jonbob0687/DEV1028/pcb/revBnotes.txt

1. mosfet - resistor to shunt charge on gate
2. pullup or pulldown resistors to keep bus translator at known levels
