jonbob0687/DEV1028/pcb/export/BillOfMaterialsrB.xlsx

Reference | Value | Footprint | Qty | DNP | MPN
C1,C2 | 100nF | Capacitor_SMD:C_0603_1608Metric | 2 |  | STASH
C3 | 1uF | Capacitor_SMD:C_0603_1608Metric | 1 |  | CC0603KRX7R9BB105
C4 | 1uF | Capacitor_SMD:C_1206_3216Metric_Pad1.33x1.80mm_HandSolder | 1 |  | HMK316B7105KL-T
D1 | 5.1V | Diode_SMD:D_SOD-323_HandSoldering | 1 |  | DNP
J1 | ScrewTerms | GM_Connector_PhoenixContact:phoenix_contact_1984691 | 1 |  | 1984691
Q1,Q2 | MMBT3904 | Package_TO_SOT_SMD:SOT-23-3 | 2 |  | WORK
Q3,Q4 | SI2304BDS-T1-GE3 | Package_TO_SOT_SMD:SOT-23 | 2 |  | SI2304BDS-T1-GE3
R1 | 10K | Resistor_SMD:R_0603_1608Metric | 1 |  | RC0603FR-0710KL
R2 | 4K7 | Resistor_SMD:R_0603_1608Metric | 1 |  | y
R3 | 2K | Resistor_SMD:R_0603_1608Metric | 1 |  | y
R4 | 20K | Resistor_SMD:R_0603_1608Metric | 1 |  | y
R5 | 100K | Resistor_SMD:R_0603_1608Metric | 1 |  | y
R6 | 680R | Resistor_SMD:R_0603_1608Metric | 1 |  | y
R7,R9 | 1K | Resistor_SMD:R_0603_1608Metric | 2 |  | y
R8,R10 | 120R | Resistor_SMD:R_0603_1608Metric | 2 |  | y
U1 | OKI-78SR-5/1.5-W36-C | Package_TO_SOT_THT:TO-220-3_Vertical | 1 |  | old
U2 | SN74AVC8T245PW | Package_SO:TSSOP-24_4.4x7.8mm_P0.65mm | 1 |  | y
U3 | XIAO-ESP32-S3-SMD | Seeed Studio XIAO Series Library:XIAO-ESP32S3-SMD | 1
