jonbob0687/DEV1028/pcb/200280rB.kicad_pcb

## KiCad design pcb/200280rB.kicad_pcb (2025-03-09)

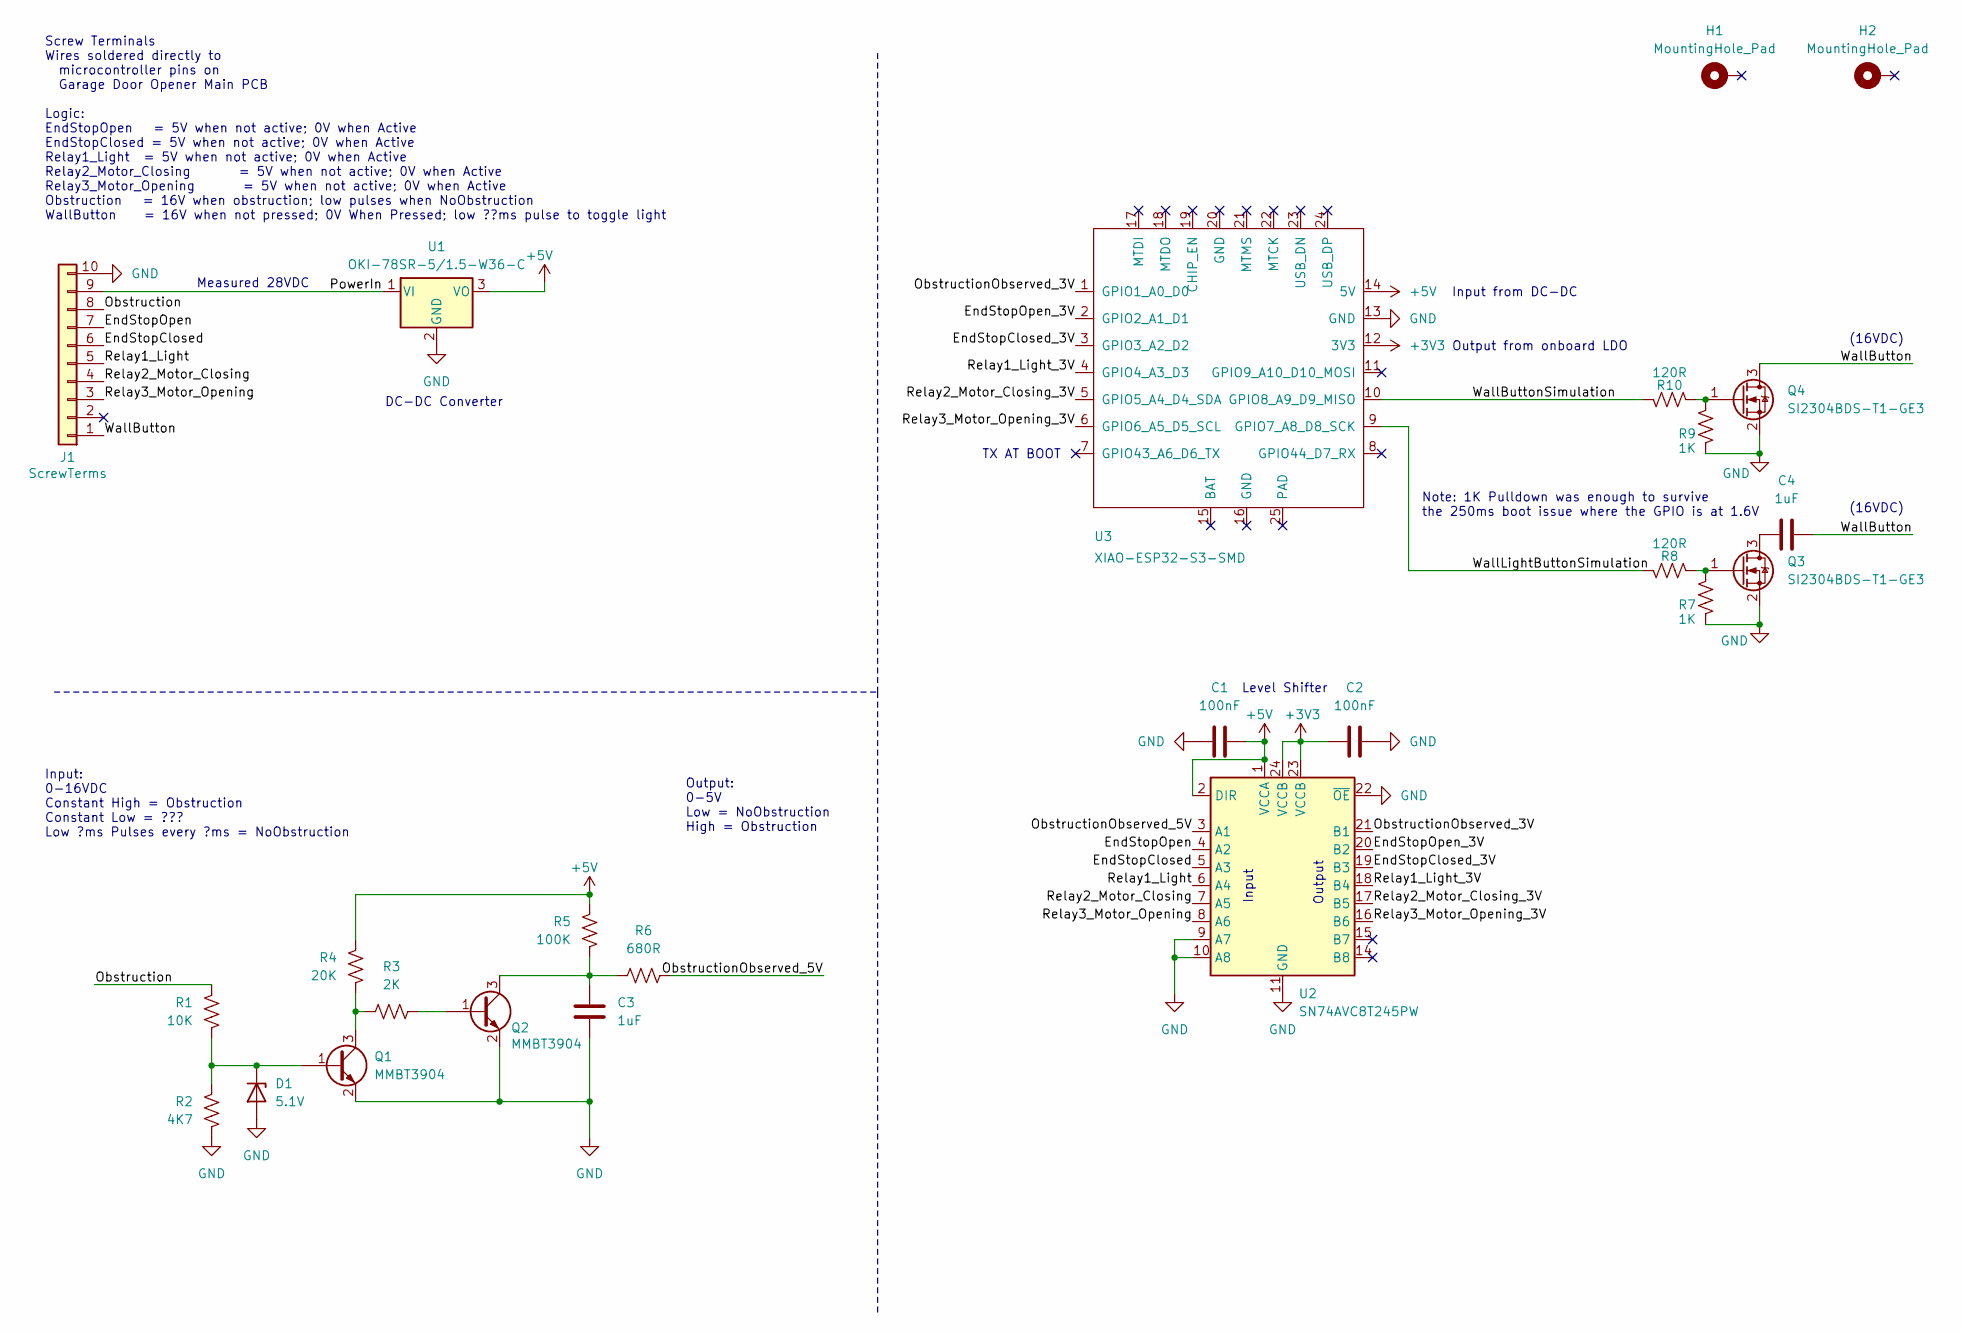
[picture p1: schematic 200280rB.kicad_sch]

Parts:
C1, C2: 100nF; C_0603_1608Metric
C3: 1uF; C_0603_1608Metric
C4: 1uF; C_1206_3216Metric_Pad1.33x1.80mm_HandSolder
D1: 5.1V; D_SOD-323_HandSoldering
H1, H2: MountingHole_Pad; MountingHole_3.2mm_M3_Pad
J1: ScrewTerms; phoenix_contact_1984691
Q1, Q2: MMBT3904; SOT-23-3
Q3, Q4: SI2304BDS-T1-GE3; SOT-23
R1: 10K; R_0603_1608Metric
R2: 4K7; R_0603_1608Metric
R3: 2K; R_0603_1608Metric
R4: 20K; R_0603_1608Metric
R5: 100K; R_0603_1608Metric
R6: 680R; R_0603_1608Metric
R7, R9: 1K; R_0603_1608Metric
R8, R10: 120R; R_0603_1608Metric
U1: OKI-78SR-5/1.5-W36-C; TO-220-3_Vertical
U2: SN74AVC8T245PW; TSSOP-24_4.4x7.8mm_P0.65mm
U3: XIAO-ESP32-S3-SMD; XIAO-ESP32S3-SMD

Connections:
+3V3: C2.1, U2.23 (VCCB), U2.24 (VCCB), U3.12 (3V3)
+5V: C1.2, R4.2, R5.2, U1.3 (VO), U2.1 (VCCA), U2.2 (DIR), U3.14 (5V)
/EndStopClosed: J1.6, U2.5 (A3)
/EndStopClosed_3V: U2.19 (B3), U3.3 (GPIO3_A2_D2)
/EndStopOpen: J1.7, U2.4 (A2)
/EndStopOpen_3V: U2.20 (B2), U3.2 (GPIO2_A1_D1)
/Obstruction: J1.8, R1.2
/ObstructionObserved_3V: U2.21 (B1), U3.1 (GPIO1_A0_D0)
/ObstructionObserved_5V: R6.1, U2.3 (A1)
/PowerIn: J1.9, U1.1 (VI)
/Relay1_Light: J1.5, U2.6 (A4)
/Relay1_Light_3V: U2.18 (B4), U3.4 (GPIO4_A3_D3)
/Relay2_Motor_Closing: J1.4, U2.7 (A5)
/Relay2_Motor_Closing_3V: U2.17 (B5), U3.5 (GPIO5_A4_D4_SDA)
/Relay3_Motor_Opening: J1.3, U2.8 (A6)
/Relay3_Motor_Opening_3V: U2.16 (B6), U3.6 (GPIO6_A5_D5_SCL)
/WallButton: C4.2, J1.1, Q4.3 (D)
/WallButtonSimulation: R10.1, U3.10 (GPIO8_A9_D9_MISO)
/WallLightButtonSimulation: R8.1, U3.9 (GPIO7_A8_D8_SCK)
GND: C1.1, C2.2, C3.2, D1.2 (A), J1.10, Q1.2 (E), Q2.2 (E), Q3.2 (S), Q4.2 (S), R2.1, R7.1, R9.1, U1.2 (GND), U2.9 (A7), U2.10 (A8), U2.11 (GND), U2.12 (GND), U2.13 (GND), U2.22 (~OE), U3.13 (GND)
unnamed: D1.1 (K), Q1.1 (B), R1.1, R2.2
unnamed: Q1.3 (C), R3.1, R4.1
unnamed: Q2.1 (B), R3.2
unnamed: C3.1, Q2.3 (C), R5.1, R6.2
unnamed: C4.1, Q3.3 (D)
unnamed: Q3.1 (G), R7.2, R8.2
unnamed: Q4.1 (G), R9.2, R10.2

Notes on the sheet:
(16VDC)
Screw Terminals Wires soldered directly to microcontroller pins on Garage Door Opener Main PCB Logic: EndStopOpen = 5V when not active; 0V when Active EndStopClosed = 5V when not active; 0V when Active Relay1_Light = 5V when not active; 0V when Active Relay2_Motor_Closing = 5V when not active; 0V w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
Output from onboard LDO
Input from DC-DC
Input: 0-16VDC Constant High = Obstruction Constant Low = ??? Low ?ms Pulses every ?ms = NoObstruction
Input
Note: 1K Pulldown was enough to survive the 250ms boot issue where the GPIO is at 1.6V
Output
Measured 28VDC
DC-DC Converter
TX AT BOOT
Level Shifter
Output: 0-5V Low = NoObstruction High = Obstruction

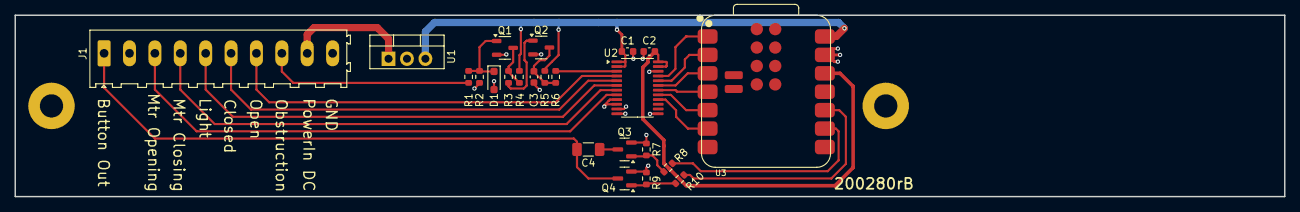
[picture p2: board 200280rB.kicad_pcb from above]

Board: 2 copper layers, 175.0 x 25.0 mm, 25 parts (0 on the bottom side), 27 nets.
