jonbob0687/DEV1028/pcb/200280.kicad_pcb

## KiCad design pcb/200280.kicad_pcb (2025-01-20)

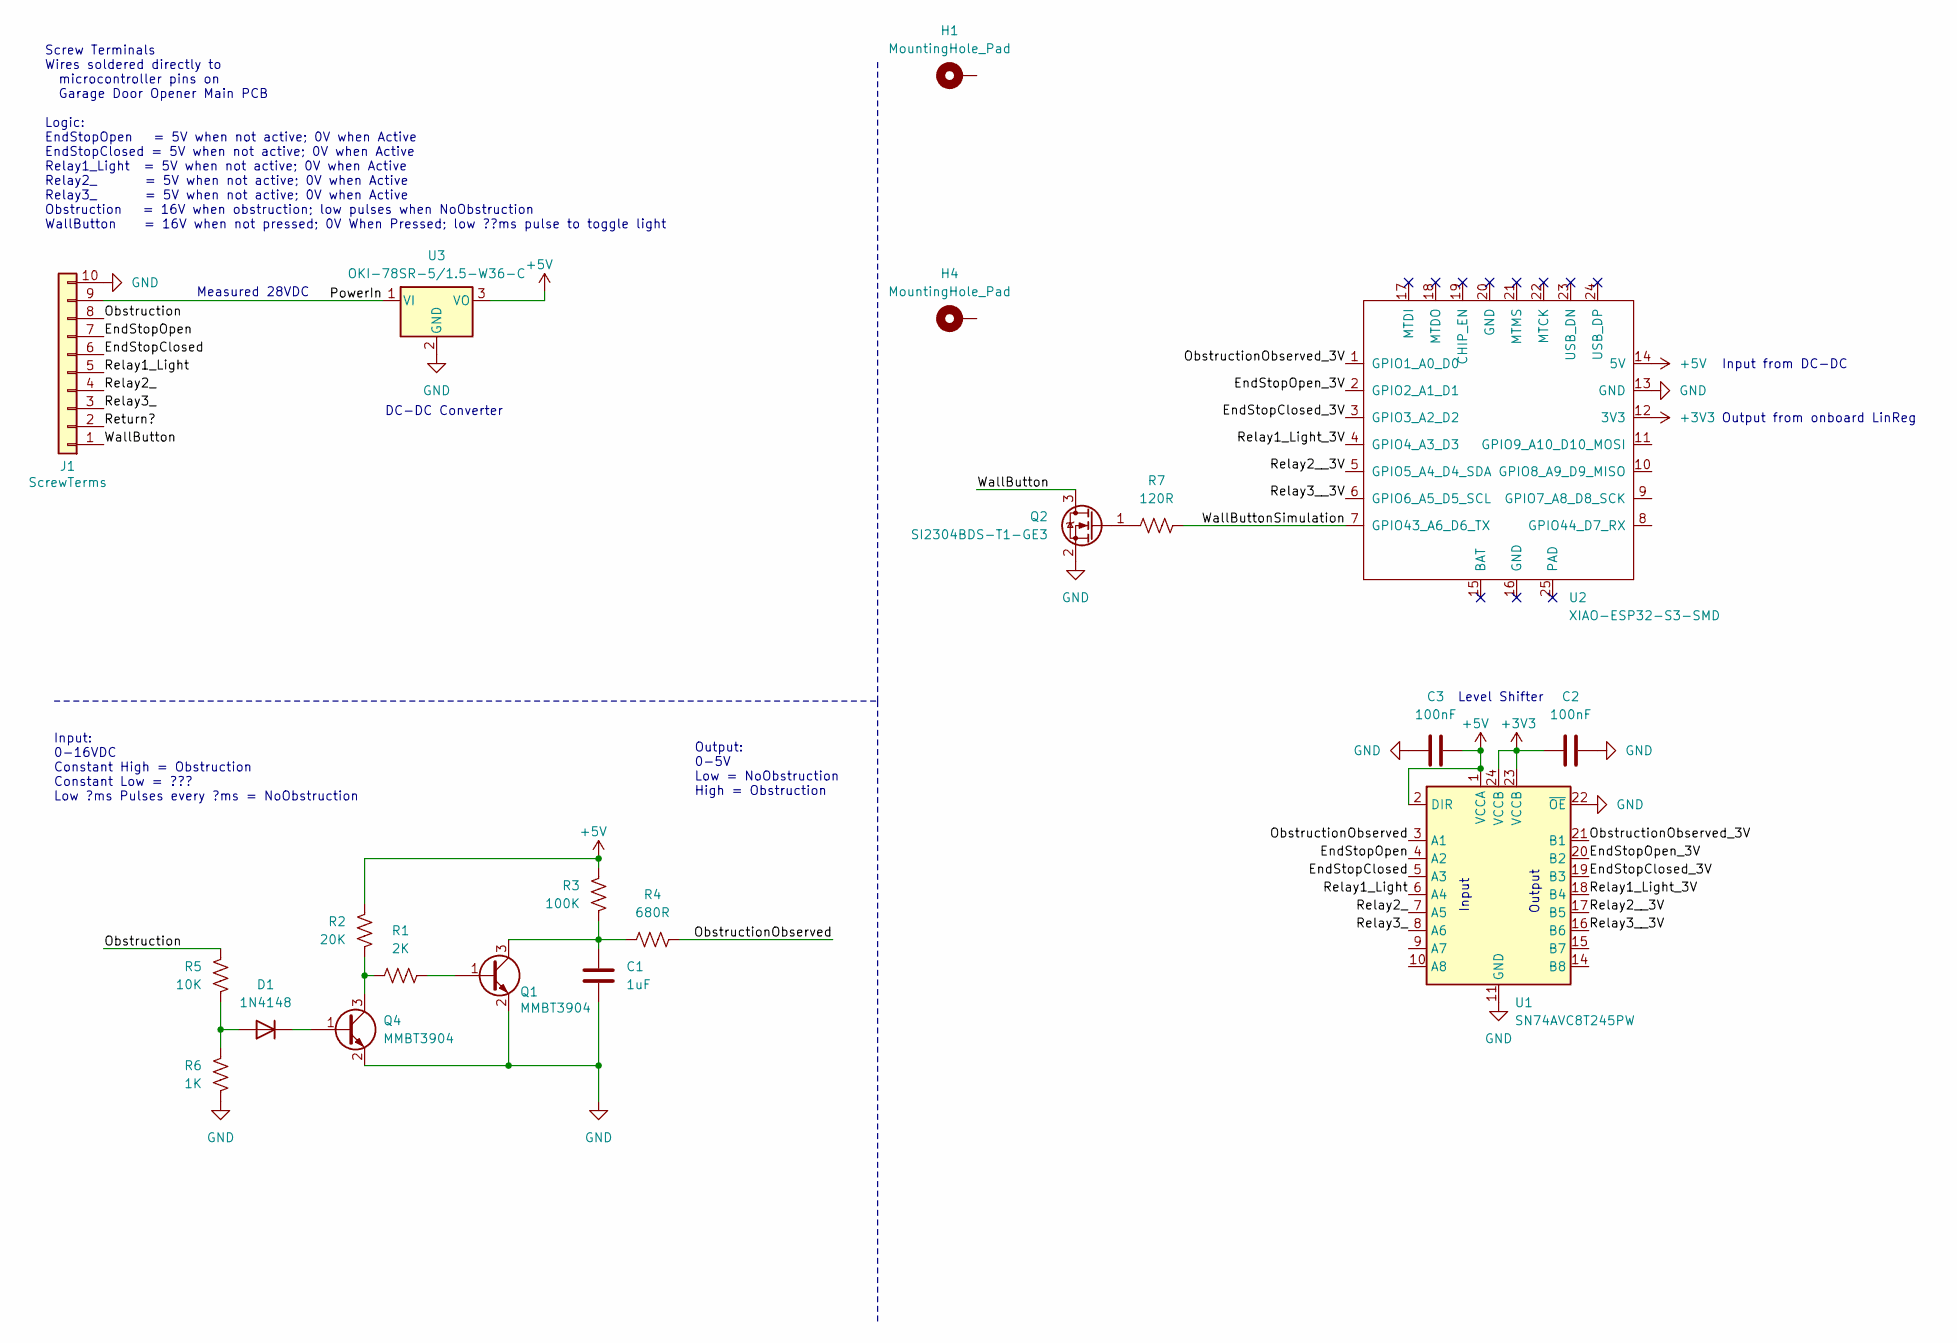
[picture p3: schematic 200280.kicad_sch]

Parts:
C1: 1uF; C_0603_1608Metric
C2, C3: 100nF; C_0603_1608Metric
D1: 1N4148; D_SOD-523
H1, H4: MountingHole_Pad; MountingHole_3.2mm_M3_Pad
J1: ScrewTerms; phoenix_contact_1984691
Q1, Q4: MMBT3904; SOT-23-3
Q2: SI2304BDS-T1-GE3; SOT-23
R1: 2K; R_0603_1608Metric
R2: 20K; R_0603_1608Metric
R3: 100K; R_0603_1608Metric
R4: 680R; R_0603_1608Metric
R5: 10K; R_0603_1608Metric
R6: 1K; R_0603_1608Metric
R7: 120R; R_0603_1608Metric
U1: SN74AVC8T245PW; TSSOP-24_4.4x7.8mm_P0.65mm
U2: XIAO-ESP32-S3-SMD; XIAO-ESP32S3-SMD
U3: OKI-78SR-5/1.5-W36-C; TO-220-3_Vertical

Connections:
+3V3: C2.1, U1.23 (VCCB), U1.24 (VCCB), U2.12 (3V3)
+5V: C3.2, R2.2, R3.2, U1.1 (VCCA), U1.2 (DIR), U2.14 (5V), U3.3 (VO)
/EndStopClosed: J1.6, U1.5 (A3)
/EndStopClosed_3V: U1.19 (B3), U2.3 (GPIO3_A2_D2)
/EndStopOpen: J1.7, U1.4 (A2)
/EndStopOpen_3V: U1.20 (B2), U2.2 (GPIO2_A1_D1)
/Obstruction: J1.8, R5.2
/ObstructionObserved: R4.1, U1.3 (A1)
/ObstructionObserved_3V: U1.21 (B1), U2.1 (GPIO1_A0_D0)
/PowerIn: J1.9, U3.1 (VI)
/Relay1_Light: J1.5, U1.6 (A4)
/Relay1_Light_3V: U1.18 (B4), U2.4 (GPIO4_A3_D3)
/Relay2_: J1.4, U1.7 (A5)
/Relay2__3V: U1.17 (B5), U2.5 (GPIO5_A4_D4_SDA)
/Relay3_: J1.3, U1.8 (A6)
/Relay3__3V: U1.16 (B6), U2.6 (GPIO6_A5_D5_SCL)
/Return?: J1.2
/WallButton: J1.1, Q2.3 (D)
/WallButtonSimulation: R7.1, U2.7 (GPIO43_A6_D6_TX)
GND: C1.2, C2.2, C3.1, J1.10, Q1.2 (E), Q2.2 (S), Q4.2 (E), R6.1, U1.11 (GND), U1.12 (GND), U1.13 (GND), U1.22 (~OE), U2.13 (GND), U3.2 (GND)
unnamed: D1.2 (A), R5.1, R6.2
unnamed: D1.1 (K), Q4.1 (B)
unnamed: Q1.1 (B), R1.2
unnamed: C1.1, Q1.3 (C), R3.1, R4.2
unnamed: Q2.1 (G), R7.2
unnamed: Q4.3 (C), R1.1, R2.1

Notes on the sheet:
Screw Terminals Wires soldered directly to microcontroller pins on Garage Door Opener Main PCB Logic: EndStopOpen = 5V when not active; 0V when Active EndStopClosed = 5V when not active; 0V when Active Relay1_Light = 5V when not active; 0V when Active Relay2_ = 5V when not active; 0V when Active Re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
Output from onboard LinReg
Input from DC-DC
Input
Output
Input: 0-16VDC Constant High = Obstruction Constant Low = ??? Low ?ms Pulses every ?ms = NoObstruction
Measured 28VDC
DC-DC Converter
Level Shifter
Output: 0-5V Low = NoObstruction High = Obstruction

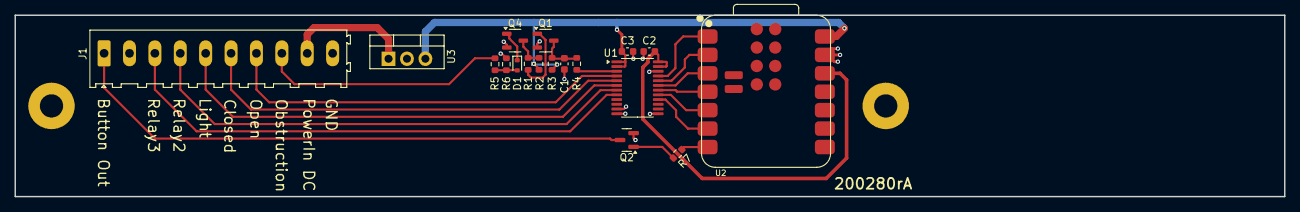
[picture p4: board 200280.kicad_pcb from above]

Board: 2 copper layers, 175.0 x 25.0 mm, 20 parts (0 on the bottom side), 25 nets.
