jonbob0687/DEV1028/firmware/up down history.PNG

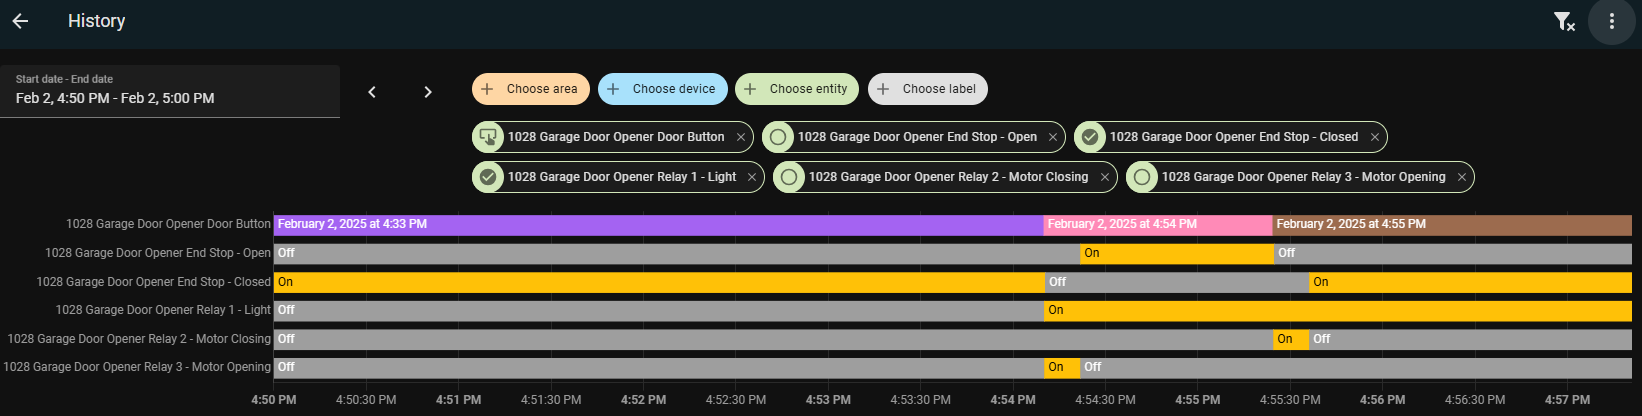
firmware/up down history.PNG
