jonbob0687/DEV1028/(commit log)

2025-01-17 basic design
    [200280.kicad_pcb, 200280.kicad_sch]
2025-01-20 final PCB design as purchased rev A
    [200280-B_Cu.gbr, 200280-B_Mask.gbr, 200280-B_Paste.gbr, 200280-B_Silkscreen.gbr, 200280-Edge_Cuts.gbr, 200280-F_Cu.gbr, 200280-F_Mask.gbr, 200280-F_Paste.gbr]
2025-02-19 add notes
    [garage door open then close without door attached.csv]
2025-02-19 add diode stuff
    [Diode Drops.xlsx]
2025-03-09 with diode drops
    [200280rB.kicad_pcb, 200280rB.kicad_sch]
2025-03-09 as purchased revision B
    [200280rB-B_Cu.gbr, 200280rB-B_Mask.gbr, 200280rB-B_Paste.gbr, 200280rB-B_Silkscreen.gbr, 200280rB-Edge_Cuts.gbr, 200280rB-F_Cu.gbr, 200280rB-F_Mask.gbr, 200280rB-F_Paste.gbr]
